jnierodzik/control-light-monitor/hardware/enclosure/exploded.png

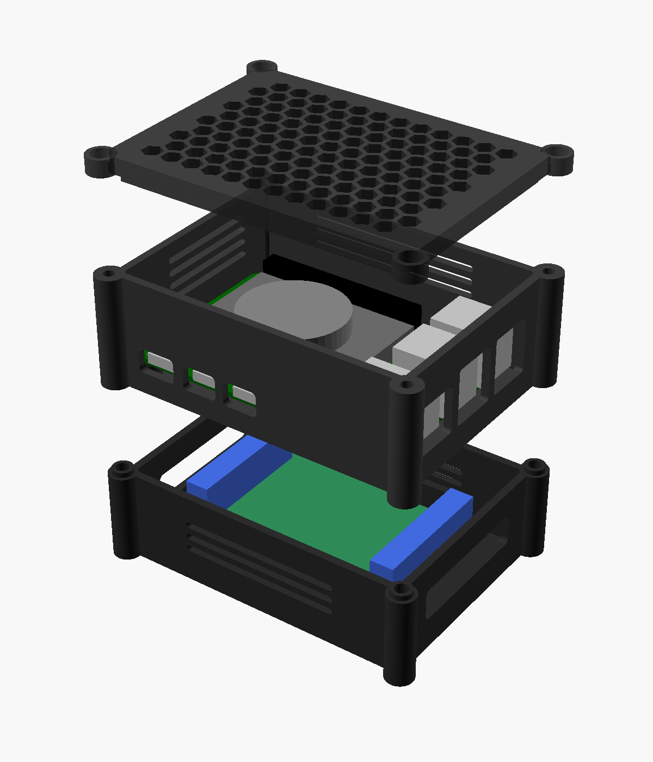
hardware/enclosure/exploded.png
