jnierodzik/control-light-monitor/hardware/enclosure/pi.stl

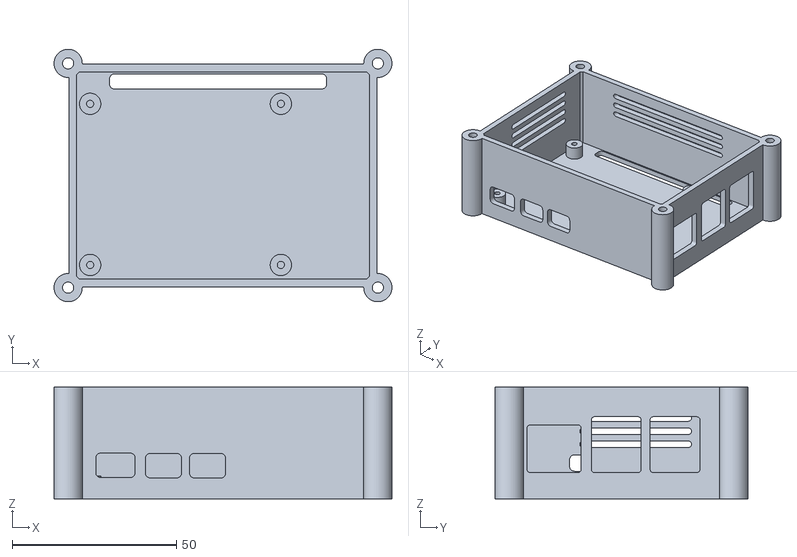
[picture p2: CAD file, 2026-10-12]
hardware/enclosure/pi.stl
102.8 x 76.8 x 34.0
