jnierodzik/control-light-monitor/hardware/enclosure/lid.stl

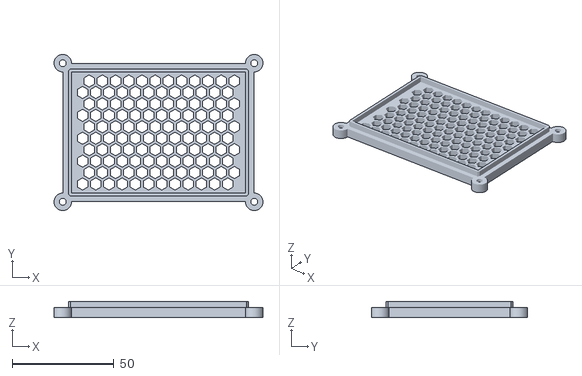
[picture p3: CAD file, 2026-10-12]
hardware/enclosure/lid.stl
102.8 x 76.8 x 8.00
