jnierodzik/control-light-monitor/hardware/enclosure/base.stl

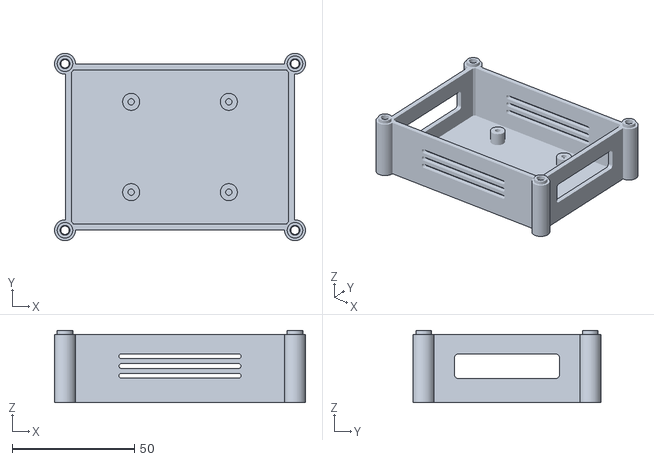
[picture p4: CAD file, 2026-10-12]
hardware/enclosure/base.stl
102.8 x 76.8 x 29.6
