jnierodzik/control-light-monitor/src/stacklight/logging_setup.py

"""Structured logging configuration.

Library modules never configure logging and never print; they call
``logging.getLogger(__name__)``. Entry points call :func:`configure_logging` once.
"""

from __future__ import annotations

import json
import logging
import sys
from typing import Any

_RESERVED = frozenset(
    logging.LogRecord("", 0, "", 0, "", (), None).__dict__.keys()
    | {"message", "asctime", "taskName"}
)


class JsonFormatter(logging.Formatter):
    """One JSON object per line, with any ``extra=`` fields merged in."""

    def format(self, record: logging.LogRecord) -> str:
        payload: dict[str, Any] = {
            "ts": self.formatTime(record, "%Y-%m-%dT%H:%M:%S%z"),
            "level": record.levelname,
            "logger": record.name,
            "msg": record.getMessage(),
        }
        for key, value in record.__dict__.items():
            if key not in _RESERVED and not key.startswith("_"):
                payload[key] = value
        if record.exc_info:
            payload["exc"] = self.formatException(record.exc_info)
        return json.dumps(payload, default=str)


class TextFormatter(logging.Formatter):
    """Human-readable line format with ``extra=`` fields appended as key=value."""

    def __init__(self) -> None:
        super().__init__("%(asctime)s %(levelname)-7s %(name)s %(message)s", "%H:%M:%S")

    def format(self, record: logging.LogRecord) -> str:
        base = super().format(record)
        extras = {
            key: value
            for key, value in record.__dict__.items()
            if key not in _RESERVED and not key.startswith("_")
        }
        if extras:
            base += " " + " ".join(f"{k}={v!r}" for k, v in extras.items())
        return base


def configure_logging(level: str = "INFO", fmt: str = "text") -> None:
    """Install a single stderr handler on the root logger.

    ``fmt`` is ``"text"`` (default, for interactive use) or ``"json"`` (for
    journald/log shipping on the node).
    """
    if fmt not in ("text", "json"):
        raise ValueError(f"unknown log format {fmt!r}; expected 'text' or 'json'")

    handler = logging.StreamHandler(sys.stderr)
    handler.setFormatter(JsonFormatter() if fmt == "json" else TextFormatter())

    root = logging.getLogger()
    for existing in list(root.handlers):
        root.removeHandler(existing)
    root.addHandler(handler)
    root.setLevel(level.upper())
