jnierodzik/control-light-monitor/(commit log)

2026-09-29 Project skeleton: config, FrameSource, SyntheticSource
    Step 1 of the build order. Establishes the foundation that makes the rest of
    the project developable with no camera attached:
    - Strict YAML config parsing and validation. Unknown keys are errors, ROIs are
    bounds-checked, and state definitions are checked for ambiguity by enumerating
    every possible segment pattern at load time.
    - State resolution with wildcard semantics: a segment a state does not mention
    is "don't care", most-specific match wins, no match resolves to "unknown"
    rather than a guess.
    - FrameSource interface where frames carry their own timestamp and camera
    controls are part of the contract, so a VirtualClock make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
    [base.py, cli.py, clock.py, config.py, dev-synthetic.yaml, errors.py, example-camera.yaml, file.py]
2026-09-29 Detection engine: ROI sampling, flash detection, debounce
    Step 2 of the build order. Frames in, committed semantic state out, with all
    timing taken from Frame.t so a virtual clock can drive minutes of scripted light
    behaviour through the engine in milliseconds.
    - metrics.py: ROI -> one brightness number, numpy only. value (max channel),
    luma, and mean_rgb.
    - detector.py: SegmentTracker classifies one region as off/steady/flashing from
    the rolling duty cycle and transition count. The configured flash_duty_range
    does double duty as the steady and off boundaries; a mid-range duty with too
    few transitions is genuinely ambiguous, so the previous mode is held rather
    than guessed, which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
2026-09-29 MQTT publisher, heartbeats, retained state
    Step 3 of the build order. The node now runs the full pipeline: capture,
    detect, publish semantic state.
    - publisher.py: Publisher interface with a paho implementation and a recording
    stand-in, so the whole runtime is testable without a broker. paho 2.x
    CallbackAPIVersion.VERSION2, last will registered before connect, background
    network thread so a slow broker never stalls the capture loop.
    - payloads.py: state, health and availability documents as pure functions over a
    Reading. Raw brightness values travel in every payload.
    - snapshot.py: annotated debug JPEG. Each ROI outlined and labelled with its
    measured value, coloured by lit/unlit,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
    [cli.py, config.py, dev-synthetic.yaml, example-camera.yaml, node.py, payloads.py, publisher.py, snapshot.py]
2026-09-29 Verify MQTT against a real broker; add Pi setup guide
    Closes the gap flagged in step 3: the MQTT path had only ever been exercised
    against a fake paho client. Verified against mosquitto 2.1.2 end to end —
    synthetic camera, real detector, real paho, real broker:
    - state published on each committed transition (idle, running, attention), with
    raw brightness values intact
    - retained state, snapshot and availability all delivered to a subscriber that
    connects after the node has exited; health correctly absent, being unretained
    - heartbeats at the configured cadence, reporting measured fps 15.0 against a
    configured 15.0
    - the last will fires on ungraceful death: SIGKILL-equivalent exit wi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
2026-09-29 PiCameraSource, systemd unit, deployment
    Pulled ahead of the calibration UI so ROIs get dialled in against the real
    camera rather than calibrated twice.
    PiCameraSource locks every automatic behaviour off, which is the point: left on
    automatic the ISP would re-normalise the deliberately black frame, shift the hue
    of a saturated LED, and hunt focus whenever the light changed.
    - AeEnable and AwbEnable false, ExposureTime and AnalogueGain pinned, AfMode
    manual with an explicit LensPosition.
    - FrameDurationLimits pinned at both ends. A single limit would let the camera
    lengthen exposure to chase a brightness target.
    - ColourGains stated explicitly, because with AWB off the ISP keeps whateve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
2026-09-29 Add enclosure guidance to the Pi setup guide
    The Pi has to sit within 500mm of the light because that is the cable length,
    which puts it in the working area of a press throwing powder residue and
    conductive brass shavings.
    Notes the cooling-versus-dust tension and resolves it: this workload draws
    roughly 4-5W against the ~12W of a busy Pi 5, so dust rather than heat is the
    binding constraint. Suggests fitting the Active Cooler with its fan lead
    unplugged, using it as a passive heatsink, and checking vcgencmd measure_temp
    before deciding whether the fan is needed at all.
    Recommends Power_Billy's mix-and-match case (wall-mount base plus the most
    closed lid that still has a cable pass-through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
2026-09-30 Bench verification on real hardware; force IPv4 for the Pi
    Pi 5 flashed and booted headless; camera confirmed working before mounting.
    - Set User=jnierodzik in the systemd unit and as the Makefile default.
    - Every Makefile ssh/scp/rsync call now forces IPv4. <host>.local resolves to an
    IPv6 link-local address first, which carries no scope id, so plain ssh fails
    with "No route to host".
    - Recorded the bench results in the setup guide: imx708 detected, 29.6C idle
    with no undervoltage, filesystem expanded.
    Documents two findings that affect the build:
    The IMX708's 1536x864 mode is cropped to a 3072x1728 sensor window, so a
    1280x720 request most likely lands on a ~47x28 degree field rat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
2026-10-01 Make the detection pipeline sensor-agnostic; add GPIO tap design note
    Groundwork for reading the stack light electrically instead of optically. No
    behaviour change: Detector.update(frame) is now a thin camera-specific wrapper
    that measures ROIs and delegates to Detector.update_values(), which takes
    per-segment numbers and runs everything from there. All 228 existing tests pass
    untouched.
    The seam was already in the right place. A camera gets a segment's value by
    averaging pixels in an ROI; a tap on the lamp lead gets it from a pin reading
    0 or 255 against the same threshold. Flash classification, debounce, state
    resolution, MQTT, the rules engine and SQLite are all shared.
    Ten new tests dr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
2026-10-01 Record that the GPIO tap must be standalone, not camera-paired
    The tap is a complete monitor in its own right: no camera hardware, no camera
    config section, no picamera2, no calibration step. A Pi with an optocoupler
    board and nothing else has to be a working node. A camera node running
    alongside is optional validation, and nothing in the tap's design may depend on
    one existing.
    This removes an option from the open supply-presence question. Deferring
    "machine off versus idle versus harness unplugged" to a camera cross-check is no
    longer available; it has to be solved inside the tap.
    Also notes what standalone requires in the code: camera: becomes optional in
    config (currently mandatory at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
2026-10-01 Model the stack light as an annunciator, not a state indicator
    The machine's light does not indicate state. It is dark when the machine is off,
    idle, AND while running -- those three are indistinguishable, so "running" is
    not observable at all. It lights only to ask for attention, and latches until
    the operator acts: red for an error, green for a completed run.
    The shipped state maps were therefore wrong. `running: {red: off, green:
    steady}` claimed green meant running when it means just-finished, and `idle`
    silently conflated off, idle and mid-run.
    Adds an `on` mode token matching steady OR flashing, via a ModeSet value type.
    Red means error whether or not the lamp blinks, and the lamp's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
    [config.py, dev-synthetic.yaml, example-camera.yaml, test_annunciator.py, test_sensor_agnostic.py]
2026-10-06 GPIO sampler and camera-free node configuration
    The tap is now configurable and samplable end to end, with no camera anywhere in
    the chain.
    - `sensor: camera | gpio` at the top level. On a GPIO node the camera section is
    not merely optional but rejected, as is dark_reference and any per-segment roi:
    a camera block on a GPIO node means someone misunderstood which sensor they
    were configuring. Conversely a pin on a camera node is rejected.
    - Segments carry `pin` instead of `roi`/`threshold`. Duplicate pins are rejected,
    since two segments sharing a pin would read identically for ever and silently.
    - GpioSampler polls the tapped leads at a configurable rate, defaulting to 100Hz
    -- ro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
    [machine1.yaml]
2026-10-06 Record measured lamp polarity from the bench
    Gray is the negative/common side and each colour wire is a switched +24V leg,
    confirmed with a spare LTA-502TJ on a 24V supply. Determines which way round the
    optocoupler inputs wire: lamp leg to +, gray to -.
    The lamp is steady when energised with no self-flashing, confirming box
    diagram 2.
2026-10-06 Record that the buzzer line is a steady signal
    Bench measurement: with purple energised the buzzer beeps on a cadence, but the
    optocoupler input LED stays solid. The pulsing is internal to the buzzer module
    and the wire is held continuously on.
    Resolves the open worry that a short-duty beep could fall below flash_duty_range
    and be classified as off. It cannot -- the tap reads steady whenever the buzzer
    is sounding.
    [machine1.yaml]
2026-10-06 Fix double inversion of GPIO input polarity
    Caught on real hardware with nothing wired: all three pins reported lit.
    gpiozero's pull_up already encodes polarity. With pull_up=True its .value is 1
    when something drags the pin low, which is exactly a sinking optocoupler.
    GpiozeroPinReader then applied active_low on top, inverting a second time, so an
    unconnected pull-up input read as energised. In the field this would have
    reported a permanent error state and sent me hunting the wiring.
    The deeper fault was that active_low and pull are not independent -- a sinking
    opto needs both pull-up and active-low, always -- yet they were two config keys
    free to disagree. Config now rejects the contradi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
    [config.py, gpio.py, test_gpio_sampler.py]
2026-10-06 Add printable enclosure for the GPIO tap node
    Parametric OpenSCAD case for a Pi 5 with Active Cooler and the NOYITO
    4-channel 24V->3.3V optocoupler. The 24V field wiring enters through a
    gland on the opposite side from the Pi, keeping machine and Pi grounds
    physically apart. STLs are rendered from the .scad and not tracked.
    [case.scad]
2026-10-06 Add printable enclosure for the Pi and optocoupler board
    Parametric OpenSCAD box, 131 x 131 x 45 external, holding a Pi 5 and the
    MT-301R4P-P side by side with a 33mm strip free for the Wago bank. Base and lid
    print flat with no supports.
    Board posts are printed plastic rather than metal standoffs, deliberately: the
    optocouplers exist so the machine's 0V and the Pi's 0V never meet, and metal
    standoffs into a common plate would bypass them. Screws self-tap into the posts.
    Hole patterns: Pi 5 at the standard 58 x 49 HAT spacing, optocoupler board at a
    measured 40 x 37.5, assumed centred on its 72.15 x 45.45 outline. Both are
    parameters at the top of the file if the posts do not line up.
    No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
    [enclosure.scad]
2026-10-06 Generate enclosure STLs from Python instead of OpenSCAD
    OpenSCAD's Homebrew cask was disabled on macOS in September 2026 for failing the
    Gatekeeper check, so the .scad file could not actually produce anything
    printable here. Replaced with an equivalent trimesh/manifold3d model that
    exports both STLs directly, and removed the .scad so there is one source of
    truth rather than two that drift.
    Same geometry and the same parameters at the top of the file. Base 145 x 131 x
    42.5 (including mounting ears), lid 131 x 131 x 5.5, both watertight and both
    printable flat without supports.
    [enclosure.scad]
2026-10-07 Fix non-manifold enclosure geometry and add Pi port access
    Both parts were unsliceable. The base had 8 edges shared by 4 faces and the lid
    had 204 plus 250 degenerate triangles -- the slicer only flagged the base
    because that is the file that got loaded first.
    Cause throughout was geometry that touched exactly rather than overlapping:
    board posts resting precisely on the floor plane, the lid lip abutting the plate
    at exactly z=0, ears meeting the wall face flush. Every union now interpenetrates
    and every cut overshoots by 1mm. The countersinks were cone primitives whose
    degenerate apex produced the 250 slivers; they are counterbores now, cylinders
    only.
    Adds a manifold_report gate to the g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
2026-10-07 Add a fit-test coupon for the optocoupler hole pattern
    88 x 61 x 9mm plate carrying only the opto board's four posts, about fifteen
    minutes to print. It checks the single dimension I am guessing at -- whether the
    measured 40 x 37.5 hole spacing really is centred on the 72.15 x 45.45 outline.
    Cheap insurance against finding out after a ten-hour box print.
2026-10-07 Make `stacklight detect` work for GPIO nodes
    detect was camera-only, so there was no way to watch the tap; the pin checks so
    far have been throwaway inline scripts. It now branches on config.sensor and
    drives a GpioSampler through Detector.update_values for a gpio node, printing
    the same table: pin values, resolved modes, candidate and committed state.
    Shared header extracted so both sensors print identically. Camera-only flags
    (--demo, --fast, --mode, --source) are rejected with a clear message on a gpio
    config rather than silently ignored.
    Also excludes hardware/ from the deploy rsync. The Pi has no use for STLs and
    they are the largest thing in the tree.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
    [cli.py]
2026-10-07 Confirm the optocoupler hole pattern against the real board
    Fit-test coupon printed and the board bolts straight on, so the assumption that
    the measured 40 x 37.5 pattern is centred on the 72.15 x 45.45 outline holds.
    Last unknown in the enclosure geometry, now measured rather than inferred.
2026-10-07 Move the Pi to the port walls and add a port-alignment test print
    The Pi sat 8mm back from the two walls its connectors face, so with the wall
    thickness a plug had to be fished 10.5mm down a slot to reach the socket.
    Workable but unpleasant, and avoidable. Margin on those two walls is now 4mm,
    putting the ports close to the openings; the Pi's corner posts merge into the
    walls, which is structurally fine.
    Adds port-test-corner.stl: the corner of the box holding the Pi, produced by
    intersecting the real base with a bounding box rather than reimplementing it, so
    the test-fit geometry is identical to the part it is testing. 102 x 73 x 31mm,
    a couple of hours rather than ten.
    This is the last u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
2026-10-07 Restore the mounting posts, which an earlier fix had silently deleted
    The base and the port test both printed as empty boxes. Cutting the cavity after
    unioning the posts in removes every post standing inside it -- and the code
    comment claimed the opposite. The cavity is now subtracted from the shell first,
    and the posts unioned in afterwards.
    Nothing caught this because a box with no posts is perfectly watertight and
    passes every manifold check. Adds posts_present(), which probes a point inside
    each post and refuses to write the STL if any are missing. Geometry needs
    assertions about the features it is supposed to have, not just about being a
    valid solid.
    With the posts back, eight non-man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
2026-10-07 Add a one-command stage target for a freshly flashed Pi
    Reproduces by hand what was set up manually on the Pi: rsync the code into the
    home directory, build a --system-site-packages venv so it can see apt's gpiozero
    and lgpio, install the package, and validate the tap config.
    No sudo and no systemd, so it works on a bare image straight out of Imager.
    Written now because an SD reflash looks likely, and redoing that setup by hand
    is the only part of a reflash that would otherwise be tedious.
2026-10-08 Fix GPIO polarity: the optocoupler board sources, it does not sink
    The MT-301R4P-P drives its output HIGH when the field input is energised and
    holds it low through an on-board pull-down when idle -- the -P suffix is PNP
    output. The tap config had active_low: true and pull: up, exactly backwards.
    The symptom did not look like a polarity error, which is why it took two days.
    With the Pi pulling up against the board's pull-down, every output sat at
    1.158V: not a logic level, but a divider landing almost exactly on the input
    threshold. Readings flipped at random -- pins read dark one evening with a single
    unexplained 13-second excursion to lit, then read permanently lit the next
    morning with n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
    [machine1.yaml]
2026-10-08 Let the node run from a GPIO sampler, so the tap can publish MQTT
    Node took a FrameSource only, which meant the tap had no way to reach a broker.
    It now accepts either and branches in step(): a camera yields frames to measure,
    a tap yields values already sampled. Snapshot publishing is the only thing
    downstream that notices, and it skips silently when there are no pixels rather
    than needing to be configured off.
    Adds NodeConfig.sample_rate_hz, because the health payload was reading
    config.camera.fps and a tap node has no camera. A camera's frame rate and a
    tap's poll rate are the same quantity to everything downstream.
    `stacklight node` now builds the right sensor from config.sensor and re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
    [cli.py, config.py, node.py, payloads.py, test_gpio_sampler.py]
2026-10-08 Rules engine: notifications, cooldowns, escalation, watchdog, history
    The decision half of the system. Subscribes conceptually to node state and
    decides what deserves waking someone up; the MQTT service wiring comes next.
    - rules/config.py: its own YAML, separate from the node config because the rules
    process runs elsewhere and should not carry a camera section around. Rejects an
    ntfy topic shorter than 10 characters, because ntfy.sh has no accounts and the
    topic name is the only thing stopping strangers reading the notifications or
    sending convincing fakes.
    - rules/store.py: SQLite history of every transition and every notification,
    including ones that failed to send -- an undeli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
    [config.py, test_rules_engine.py, validation.py]
2026-10-08 Rules service, CLI, and the machine rules config
    Connects the engine to a live broker. The service is deliberately thin -- all the
    judgement is in the engine, which has no network and no clock of its own.
    - rules/service.py subscribes to state, health and availability under the
    configured base topic, queues messages off the paho thread, and ticks the
    time-based rules every 5 seconds. It resubscribes on every connect rather than
    just the first, so a reconnect gets retained state replayed into it.
    - `stacklight rules` runs it, with --dry-run to evaluate everything and print
    what would have been sent.
    - `stacklight history` summarises the log: how many times each state, mean and
    long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
    [cli.py, test_rules_service.py]
2026-10-08 Deployment: rules systemd unit, Pi rules config, install path
    Makes the system survive a reboot rather than living in whatever shell started
    it.
    - systemd/stacklight-rules.service, with StateDirectory=stacklight so the history
    database outlives a restart, and Restart=always with no start limit: the thing
    that tells you the machine needs you has to come back on its own.
    - config/rules-pi.yaml pointing at a broker on localhost and
    /var/lib/stacklight/history.sqlite, since mosquitto now runs on the node.
    - `make install-cmd` prints the one-time root setup rather than trying to run it.
    Every step needs sudo, sudo wants a password, and ssh cannot supply one; a
    target that silently half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
2026-10-08 Point make deploy at the tap config, not the camera
    NODE defaulted to machine1, so deploy would have shipped config/machine1.yaml to the Pi
    and enabled stacklight-node@machine1 -- the camera config, which needs picamera2 and
    a camera that is not attached. The service would have failed to start.
    Defaults to machine1 now, and the variable is documented as the config basename
    that doubles as the systemd instance name.
2026-10-08 Bring the enclosure generator under lint
    hardware/enclosure.py sits outside src/, so it had never been formatted and its
    print calls were tripping T20. The prints are correct -- the script's entire
    interface is telling you each STL's dimensions and whether it cleared the
    manifold and post-presence checks -- so this exempts the file the same way
    cli.py is already exempt, rather than silencing the output.
    Formatting here is whitespace only; the geometry is untouched.
2026-10-08 Say where make deploy runs, and drop the stale example
    The header example still read PI_USER=jesse NODE=machine1 -- a username that was
    never right and the camera config, which needs picamera2 and a camera that is
    not attached. It also never said which machine to run it from, and that caused a
    real "No rule to make target 'deploy'" on the Pi.
2026-10-08 Retry notifications the network would not carry
    A failed push was logged and dropped. For a state indicator that would sort itself
    out -- the light keeps asserting what it is, so the next publish carries the same
    information. The machine's light is an annunciator: it latches, the node publishes
    `error` exactly once on the transition, and nothing about the machine will ever
    trigger a second attempt. So one failed POST meant the alert was gone, leaving a
    delivered=0 row in SQLite next to a phone that never buzzed. The cooldown was
    correctly not claimed, which sounds like the escape hatch but isn't, because the
    next notification needs a state change and a latched lamp produces none.
    Not academ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
    [config.py, test_notification_retry.py]
2026-10-08 Fix the isolation diagram, which drew the one wire it forbids
    The drawing ran gray across the barrier to Pi GND, directly contradicting the
    bolded warning underneath it about never bonding the machine's common to the Pi's
    ground. The bench rig was always wired correctly -- gray terminates at the
    optocoupler's IN-, and the Pi side only ever sees VCC, GND and OUT -- so this was
    a drawing error, not a wiring one.
    Worth more than a quiet correction because the failure mode is silent: bonding the
    grounds leaves a tap that still appears to work, and this diagram is the reference
    for building the real harness.
2026-10-08 Write down what this is built from
    The parts list lived only in a chat log. When it came time to build the harness,
    nothing in the repo could say which cable had been ordered or what the Wago count
    was for -- so the build stalled on a question the project should have been able to
    answer about itself.
    Records the reasoning, not just the part numbers: why the optocoupler has to be
    24V->3.3V rather than the far more common 3.3V->24V, why the Wagos are the
    3-conductor size, and why the extension lead's own black-and-red wires are
    meaningless to us. No purchase links -- listings churn, and a dead link is worse
    than a part number you can search.
    Also records what was verified on the lead before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
2026-10-08 Record the optocoupler channel map
    The lamp-to-GPIO mapping existed only as a behaviour we had observed on the bench:
    energise one lamp, see which segment reports. That is fine until someone has to
    rewire the board, at which point there is nothing to check the work against.
    Also records why the three input negatives are bridged -- the board gives each
    channel its own pair and the machine has a single common, so the bridge is what
    makes one gray return serve three channels. Worth stating explicitly, because a
    bridge between grounds is exactly the thing this design warns against elsewhere,
    and this one is safe precisely because it stays on the machine side.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
2026-10-08 Record the sense wire colour assignment
    Four wires run from the harness Wagos to the optocoupler inputs, and until now
    nothing said what colour each should be -- so the only way to know what a wire did
    was to trace it end to end.
    Black for the common is the load-bearing one. It is the universal convention for a
    return, and the single mistake in this build that can actually damage something is
    getting a lamp leg and the common the wrong way round at the input terminals. A
    colour that says "this is the return" is a guard against that.
    Green and red match the light's own wires exactly; blue stands in for purple, which
    is not among the spools on hand, and is the only substitution to remember.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
2026-10-09 Record the harness map, measured on the press
    Which Wago carries which signal was an assumption drawn from the light box's
    wiring diagram. Measured on the machine, two of the four do not match it: the
    diagram puts green on pin 2 and red on pin 3, and the readings are the other way
    round.
    Recorded as measurement rather than correcting the pin table, because it is not
    clear which of the two is wrong -- the diagram may not describe this harness, or
    the Wago labels may not run in pin order. Nothing downstream depends on pin
    numbers, only on which Wago feeds which channel, so the distinction can stay open.
    Had this been wired from the diagram, the red lamp would have landed on the buzzer
    channe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
2026-10-09 Correct the harness map: W1 is the buzzer, W4 is the common
    The recorded map had the connector backwards. Wired from it, the tap's common
    sat on the purple buzzer leg, so return current from the green channel reached
    gray only by passing through the buzzer -- about 10mA, too little to trigger the
    optocoupler and more than enough to sound it. The machine beeped continuously
    through every run while the tap reported the buzzer channel at 0.0.
    The earlier reading was not careless. Every voltage was taken correctly; they
    were just all referenced to W1, and with the buzzer unenergised purple sits at
    essentially gray potential. Measuring from purple looks identical to measuring
    from the common. Th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
2026-10-12 Make bootstrap match the node it actually deploys
    The target still described the camera build. It installed picamera2, which a GPIO
    node never loads, and omitted mosquitto, gpiozero and lgpio, which it cannot run
    without -- so a freshly flashed Pi came out of bootstrap unable to start.
    It also ran sudo over a non-interactive ssh, which cannot prompt for a password.
    That fails with nothing useful printed, which is the worst way for a setup step to
    break: it looks like it ran. Now uses ssh -t.
    The gpiozero and lgpio packages come from apt rather than pip on purpose. RPi.GPIO
    does not work on the Pi 5 at all -- the RP1 south bridge moved the GPIO off the
    SoC -- and the apt builds are the ones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
2026-10-12 Teach the config what the machine actually does
    The state table said the light was a pure annunciator -- dark when off, idle and
    running alike, lighting only to ask for attention. That was wrong about green, and
    observing the real press is what showed it:
    green steady a cycle is RUNNING, lit the whole time
    green flashing the cycle COMPLETED, waiting to be dismissed
    red on fault, latched
    all dark off, or idle
    Both green states were matched by `green: "on"` and resolved to `done`. So the
    notification fired the moment a run STARTED, and when the cycle genuinely finished
    the state did not change -- no transition, no second notification. A false alert at
    the start an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
    [machine1.yaml]
2026-10-12 Record the first correct production cycle
    The tap read a real run on the machine end to end: steady green committed `running`
    and stayed silent, flashing green committed `done` and pushed, and the buzzer
    stayed quiet throughout.
    That last part is the harness map fix holding under real machine load, and the
    first two are the state table fix -- the old config would have alerted at 21:53:28
    when the run started and then said nothing at all when it finished.
    Also notes what this cycle did not prove. Red has only ever been energised from a
    bench supply; the error path shares the whole downstream chain and resolves from
    the same table, but it has not been seen on the machine and should not be ca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
2026-10-12 Announce runs starting, and give the Pi a clean way to stop
    Two operator-driven changes.
    `running` now notifies. The earlier config argued against it -- an alert every
    time the handle is pulled is how a channel gets muted -- but that missed what it
    buys here. Every run is started by hand, so the alert is the operator confirming
    the entire chain is alive at the moment they would most notice its absence: lamp,
    tap, optocoupler, Pi, broker, rules, network, phone. Expecting a buzz and not
    getting one detects a failure nothing else can. The heartbeat watchdog runs on the
    same Pi as the node it watches and so cannot report that Pi being dead; a person
    standing at the machine can.
    cooldown_s is 0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
2026-10-12 Make restart restart both services, and able to sudo
    It restarted only the node. A config change usually touches both, so restarting
    the node alone left the rules engine running the previous rules with nothing to
    indicate it -- which is exactly what happened when `running` was switched from
    silent to notifying: the file on disk was right, the process was not, and both
    looked healthy.
    Also runs under ssh -t. Sudo over a non-interactive ssh cannot prompt for a
    password and fails printing nothing useful, so the target appeared to succeed
    while doing nothing. Third target in this Makefile with that bug.
    Prints both services' state afterwards, so "it ran" and "it worked" stop being
    the same cla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
2026-10-12 Keep a planned restart quiet
    `make restart` paged the operator. Observed on the unit:
    22:11:55 rules: shutting down signal='SIGTERM'
    22:11:56 rules: notification sent 'machine1: monitor offline'
    22:11:56 rules: mqtt disconnected
    systemd stops both units together. The node publishes `availability: offline` as
    it exits -- deliberately, so a real crash is reported in seconds rather than
    waiting out the heartbeat timeout -- and the rules engine, still draining its
    queue after its own SIGTERM, processed that goodbye and raised the watchdog one
    second before stopping itself.
    So the service now drops messages once a stop has been requested. A process on its
    way out is in no position to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
    [test_rules_service.py]
2026-10-12 Make the documentation describe what this actually is
    The README opened with "watch a machine's stack light with a Raspberry Pi camera"
    and explained the underexposure technique before anything else. The live
    installation has not used a camera for days. It now leads with the electrical tap
    and keeps the camera as the second, still-supported path, with the camera-only
    sections -- dark reference, brightness metric, snapshots -- labelled as such.
    Also corrects a claim that outlived its truth. Three documents and two configs
    still asserted the light was a pure annunciator, dark when off, idle and running
    alike, with running unobservable. That is true of red and wrong about green, and
    it was not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
    [machine1.yaml]
2026-10-12 Replace the case work with the enclosure actually in use
    A three-layer stack: optocoupler board at the bottom, Pi 5 and its Active Cooler
    above it, honeycomb lid on top, with four M3 x 40 bolts running the full height
    into heat-set inserts. 102.8 x 76.8 x 67 mm.
    Deletes both earlier attempts. hardware/enclosure.py generated a single-box design
    that was never printed and whose trimesh dependency was never declared anywhere, so
    it could not run from a clean checkout. hardware/tap-enclosure/ was superseded by
    it. Neither is the case on the bench, and keeping drawings of enclosures nobody has
    is how a hardware directory stops being trustworthy.
    The STLs are tracked, which is an exception to th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
    [base.stl, case.scad, lid.stl, pi.stl, pi5_stack_enclosure.scad]
2026-10-17 Rewrite the README as a build guide
    It had grown into a 516-line design document: how the detector classifies
    flashing, what the brightness metrics mean, why the dark reference exists. All of
    that is worth keeping and none of it helps someone who wants to build one.
    The README is now what to buy, what to print, how to wire it and how to deploy it,
    in seven steps and 170 lines. The design document moves to docs/design.md intact,
    with its links rebased, and the README points at it.
    Two things are called out in the build steps rather than left to the design notes,
    because both cost real time here and both are silent when wrong: work out which
    harness wire is which by measuring rather than fro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
2026-10-17 Keep the camera out of the README
    Someone landing on this repo wants to build the thing it became, not read about
    the approach it started with. The camera is still supported and still tested, and
    the design notes still explain it -- but it has no business in the build guide.
    Removes the closing paragraph about the camera path and drops docs/pi-setup.md
    from the index. That document is titled "from sealed boxes to a verified camera"
    and walks through camera cables and camera verification, so pointing a new builder
    at it from a tap-focused README was worse than not linking it. It is still reached
    from the design notes.
2026-10-17 Delete the camera-era setup guide, keeping what still applied
    docs/pi-setup.md was 450 lines titled "from sealed boxes to a verified camera":
    camera cable checks, camera verification, exposure calibration, and an enclosure
    section describing a case that no longer exists. The README now covers setup for
    the build this actually became, so the document was wrong where it was not
    redundant.
    Two sections survived the cut and move into the design notes, because neither was
    camera-specific and both cost real time here:
    Where the broker lives -- the three options for placing the broker and rules
    engine, and the structural gap in all of them where a dead Pi takes its own
    watchdog with it. This also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
2026-10-19 Make the repo generic, and say where the machine name goes
    Strips every reference to the specific machine. The node id, the config filename,
    the systemd instance name and the notification titles all carried it, so this is a
    rename rather than a find-and-replace over prose:
    config/machine1.yaml -> config/machine1.yaml
    config/machine1.yaml -> config/example-camera.yaml
    node_id machine1 -> machine1
    "Machine fault" -> "Machine fault"
    hostname stacklight -> stacklight
    PI_USER / User= -> pi, flagged in both units as a placeholder that
    systemd will refuse to start if left wrong
    "industrial machine" goes too. It was the identifying p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
    [machine1.yaml]
2026-10-19 Let an installation name its machine without the repo knowing it
    The repo is generic and should stay that way; the thing on the shop floor should
    say what it actually is. Those are not in tension, they just need the override to
    reach the node config too.
    `make deploy` already preferred config/rules-pi.local.yaml when present. It now
    does the same for the node config, so config/<NODE>.local.yaml carries node_id --
    which is what the monitor-health alerts use, since those are generated in code
    rather than read from a rule.
    README rewritten around that: copy the two configs to .local.yaml, name the machine
    there, and the checkout stays clean. Editing the committed files is still offered,
    becau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
